mlab-modules/QFHMIX01/doc/src/img/QFHMIX01E_top.jpg

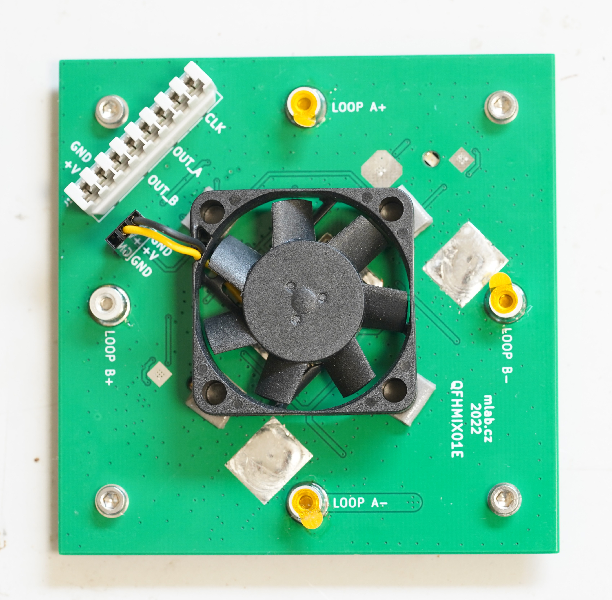
doc/src/img/QFHMIX01E_top.jpg
