mlab-modules/QFHMIX01/doc/gen/README.md

# PCB

Board size: 90.93x90.93 mm (3.58x3.58 inches)

- This is the size of the rectangle that contains the board
- Thickness: 1.6 mm (63 mils)
- Material: FR4
- Finish: None
- Layers: 2
- Copper thickness: 35 µm

Solder mask: TOP / BOTTOM

- Color: Green

Silk screen: TOP / BOTTOM

- Color: White

Stackup:

| Name | Type | Color | Thickness | Material | Epsilon_r | Loss tangent |
|---|---|---|---|---|---|---|
| F.SilkS | Top Silk Screen | | | | | |
| F.Paste | Top Solder Paste | | | | | |
| F.Mask | Top Solder Mask | Green | 10 | | | |
| F.Cu | copper | | 35 | | | |
| dielectric 1 | core | | 1510 | FR4 | 4.5 | 0.020 |
| B.Cu | copper | | 35 | | | |
| B.Mask | Bottom Solder Mask | Green | 10 | | | |
| B.Paste | Bottom Solder Paste  | | | | | |
| B.SilkS | Bottom Silk Screen | | | | | |

# Important sizes

Clearance: 0.15 mm (6 mils)

Track width: 0.2 mm (8 mils)

- By design rules: 0.2 mm (8 mils)

Drill: 0.4 mm (16 mils)

- Vias: 0.5 mm (20 mils) [Design: 0.4 mm (16 mils)]
- Pads: 0.4 mm (16 mils)
- The above values are real drill sizes, they add 0.1 mm (4 mils) to plated holes (PTH)

Via: 0.75/0.4 mm (30/16 mils)

- By design rules: 0.4/0.3 mm (16/12 mils)
- Micro via: no [0.2/0.1 mm (8/4 mils)]
- Burried/blind via: no

Outer Annular Ring: 0.1 mm (4 mils)

- By design rules: 0.1 mm (4 mils)

Eurocircuits class: 6C
- Using min drill 0.35 mm for an OAR of 0.13 mm

# General stats

Components count: (SMD/THT)

- Top: 0/2 (THT)
- Bottom: 218/15 (SMD + THT)

Defined tracks:

- 0.15 mm (6 mils)
- 0.2 mm (8 mils)
- 0.25 mm (10 mils)
- 0.3 mm (12 mils)
- 0.4 mm (16 mils)
- 0.5 mm (20 mils)
- 0.6 mm (24 mils)
- 0.8 mm (31 mils)

Used tracks:

- 0.2 mm (8 mils) (53) defined: yes
- 0.25 mm (10 mils) (71) defined: yes
- 0.3 mm (12 mils) (118) defined: yes
- 0.4 mm (16 mils) (157) defined: yes
- 0.5 mm (20 mils) (152) defined: yes
- 0.6 mm (24 mils) (42) defined: yes
- 0.8 mm (31 mils) (257) defined: yes
- 3.0 mm (118 mils) (22) defined: no

Defined vias:

Used vias:

- 0.75/0.4 mm (30/16 mils) (Count: 483, Aspect: 2.1 A) defined: no
- 1.0/0.5 mm (39/20 mils) (Count: 109, Aspect: 1.6 A) defined: no

Holes (excluding vias):

- 0.3 mm (12 mils) (27)
- 0.4 mm (16 mils) (48)
- 0.5 mm (20 mils) (60)
- 0.89 mm (35 mils) (6)
- 1.4 mm (55 mils) (8)
- 1.6 mm (63 mils) (6)
- 2.7 mm (106 mils) (2)
- 3.0 mm (118 mils) (4)
- 4.45 mm (175 mils) (4)

Oval holes:

Drill tools (including vias and computing adjusts and rounding):

- 0.4 mm (16 mils) (27)
- 0.5 mm (20 mils) (531)
- 0.6 mm (24 mils) (169)
- 1.0 mm (39 mils) (6)
- 1.5 mm (59 mils) (8)
- 1.6 mm (63 mils) (6)
- 2.7 mm (106 mils) (2)
- 3.1 mm (122 mils) (4)
- 4.45 mm (175 mils) (4)
