mlab-modules/QFHMIX01/doc/gen/img/QFHMIX01E-bottom.png

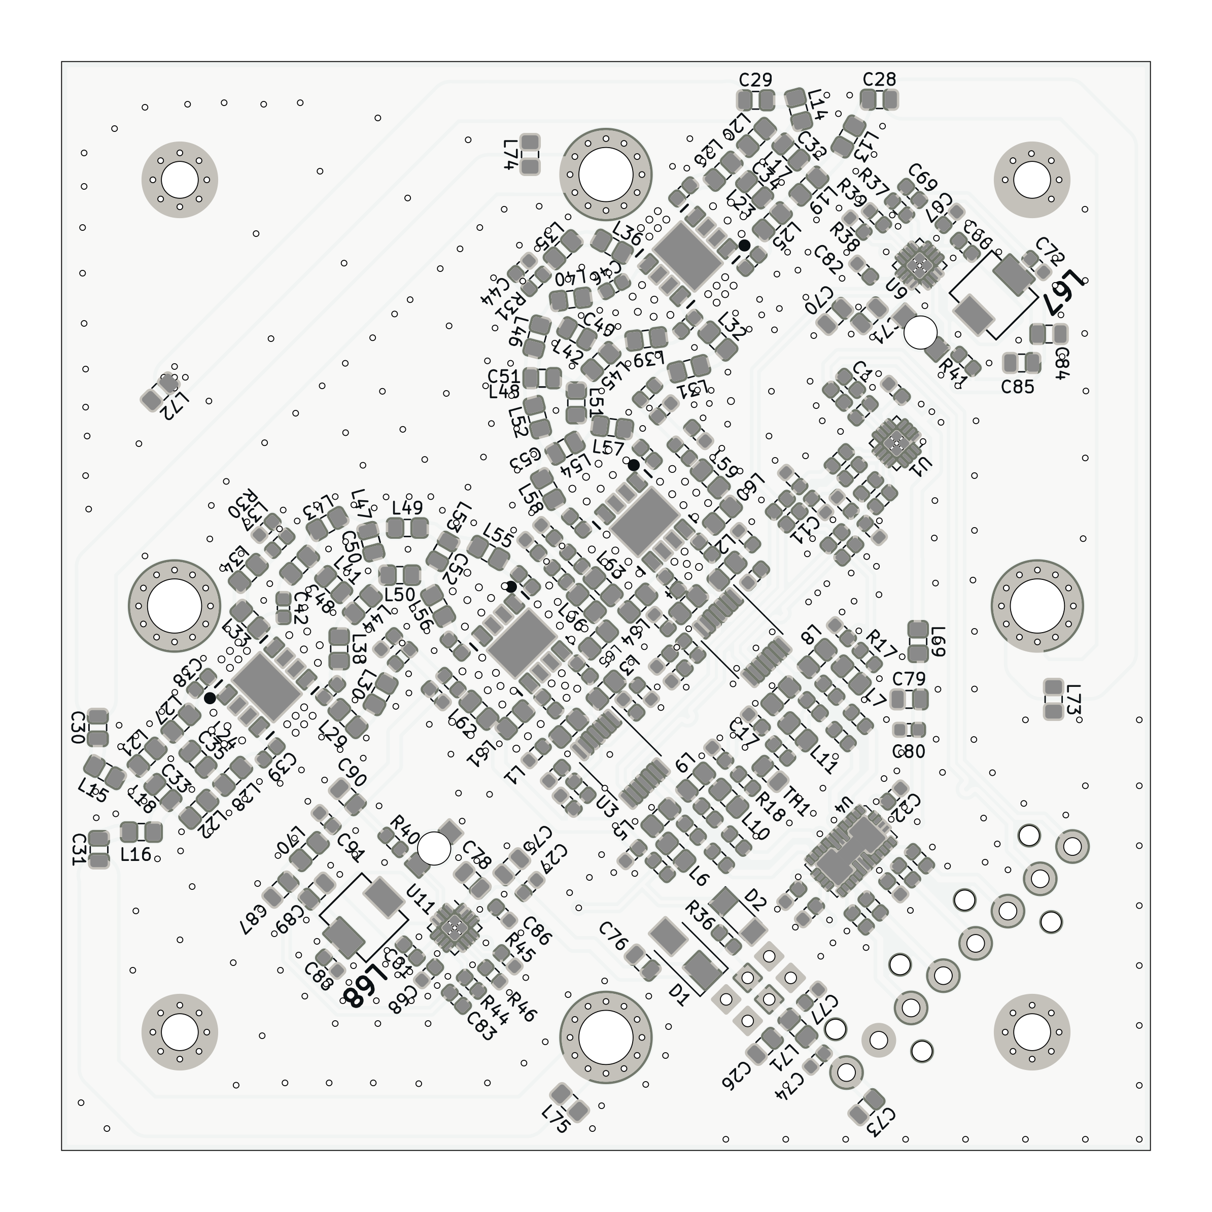
doc/gen/img/QFHMIX01E-bottom.png
