mlab-modules/QFHMIX01/doc/gen/img/QFHMIX01E-top.png

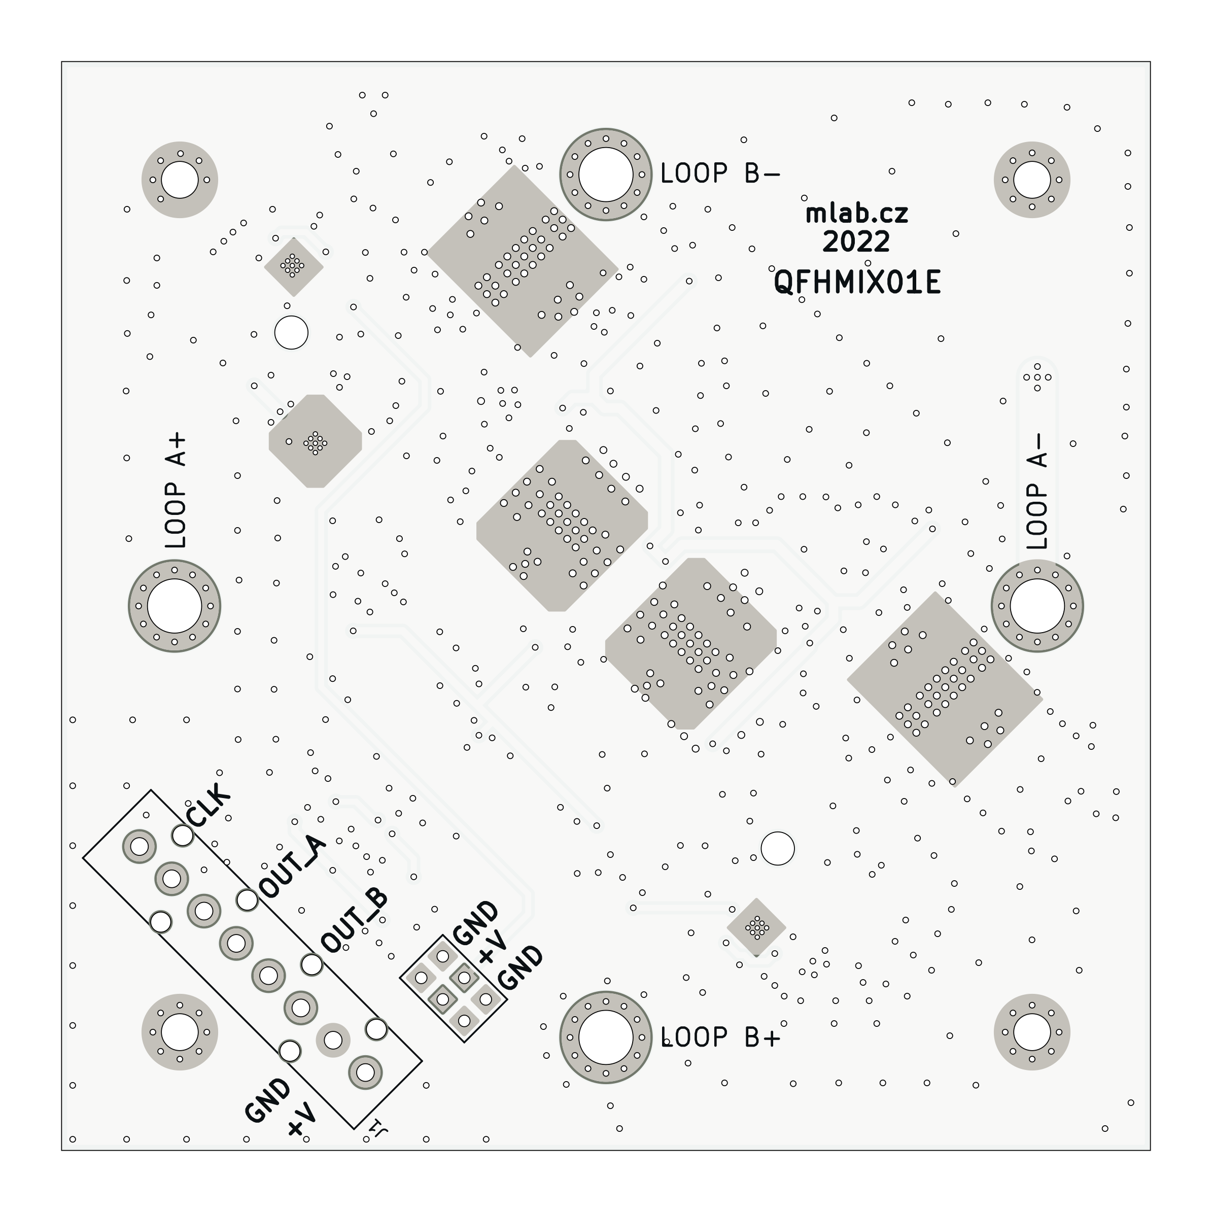
doc/gen/img/QFHMIX01E-top.png
