mlab-modules/QFHMIX01/doc/NoiceCalc.png

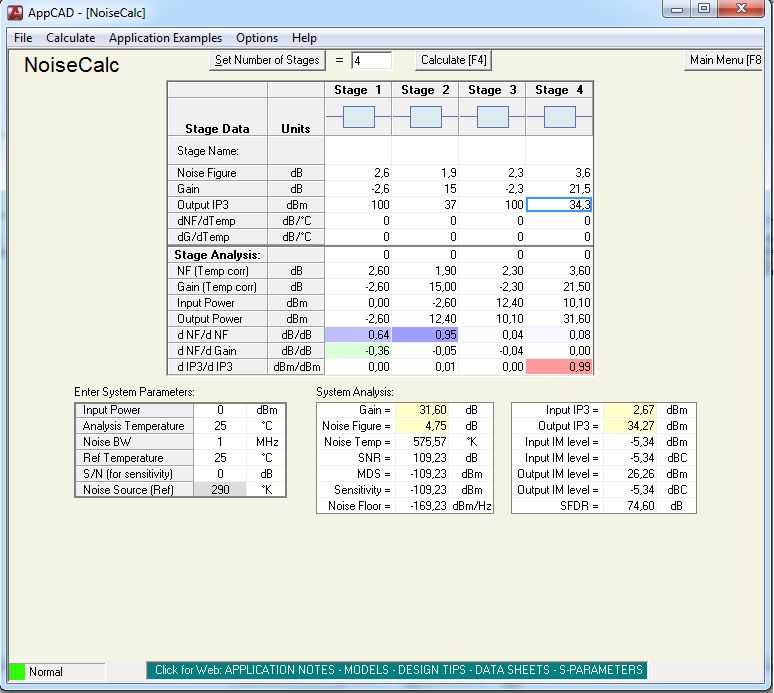
doc/NoiceCalc.png
