mlab-modules/QFHMIX01/doc/gen/dxf/QFHMIX01E-B_Fab.dxf

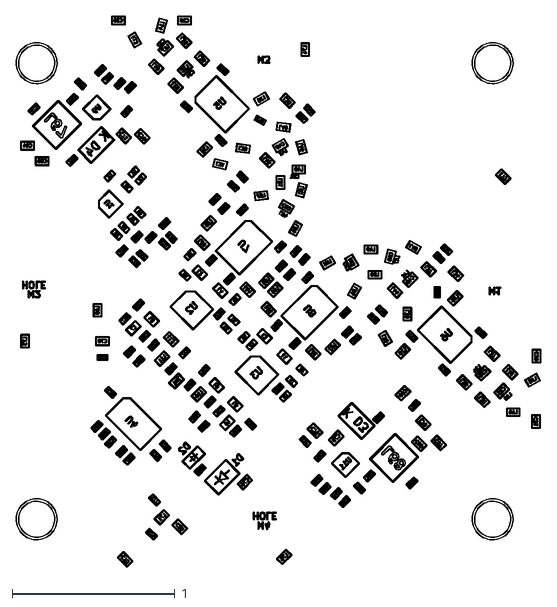
[picture p11: CAD file, 2022-08-20]
doc/gen/dxf/QFHMIX01E-B_Fab.dxf
3.22 x 3.38
