mlab-modules/QFHMIX01/doc/gen/QFHMIX01E.step

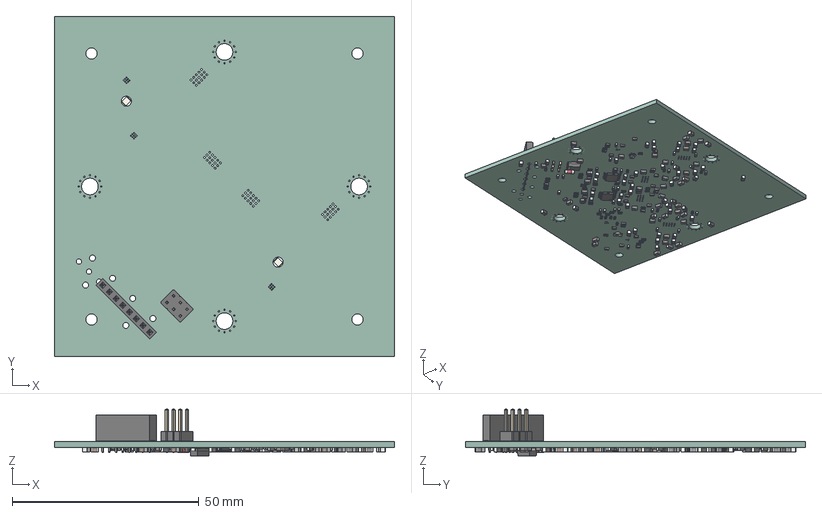
[picture p12: CAD file, 2023-02-14]
doc/gen/QFHMIX01E.step
90.9 x 90.9 x 12.5 mm
tmpxrz9fpc8 PCB
