mlab-modules/QFHMIX01/hw/cad/spacer.stl

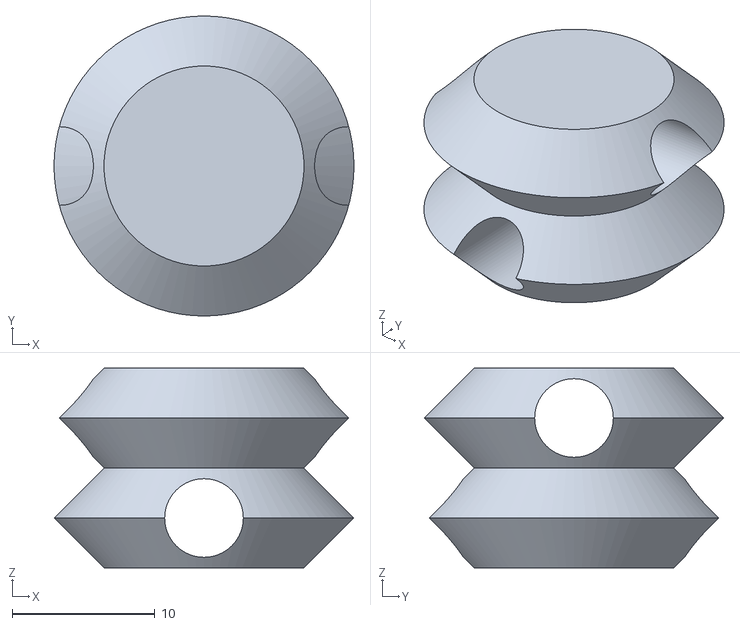
[picture p13: CAD file, 2022-09-10]
hw/cad/spacer.stl
21.0 x 21.0 x 14.0
