mlab-modules/QFHMIX01/doc/gen/dxf/QFHMIX01E-B_Cu.dxf

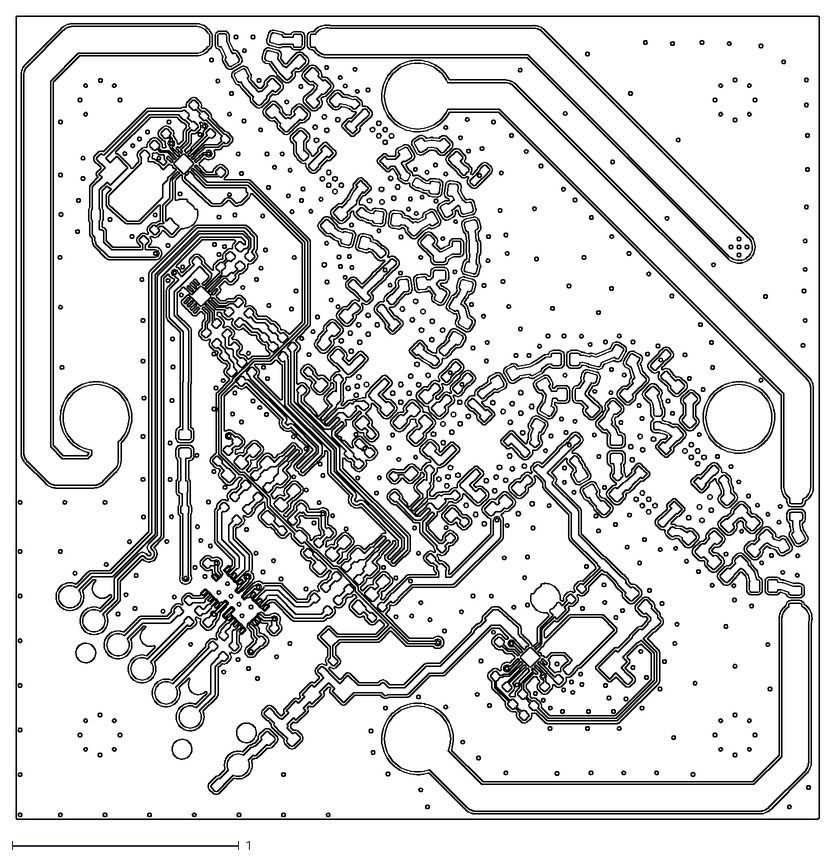
[picture p14: CAD file, 2022-08-10]
doc/gen/dxf/QFHMIX01E-B_Cu.dxf
3.54 x 3.54
