mlab-modules/QFHMIX01/hw/cad/ALBASE_MOLEX_93604.DXF

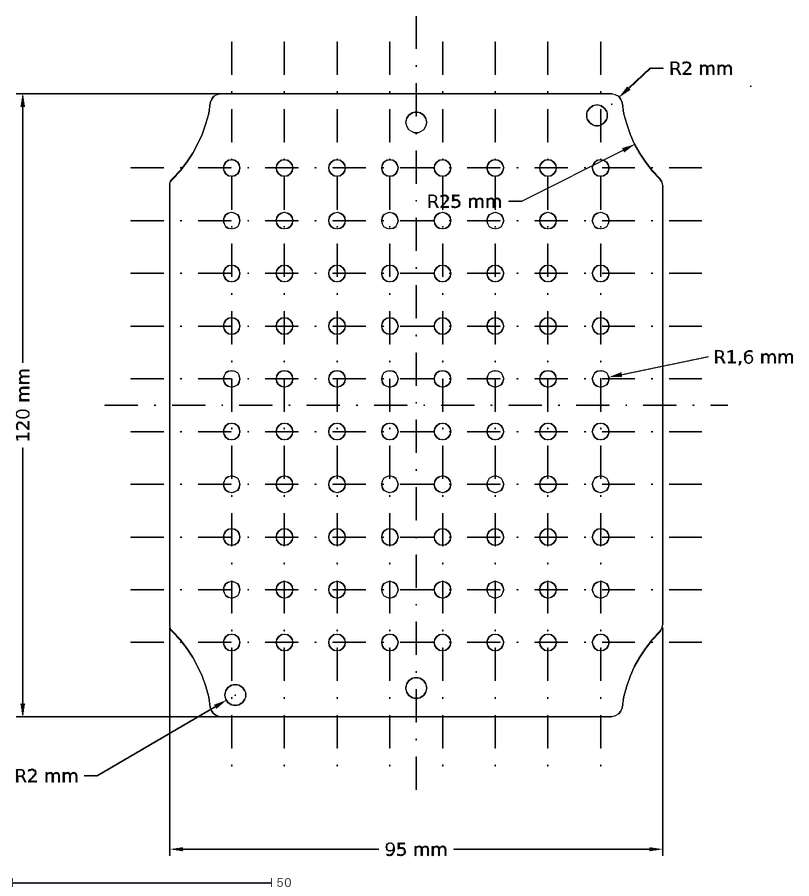
[picture p15: CAD file, 2020-06-15]
hw/cad/ALBASE_MOLEX_93604.DXF
120 mm
95 mm
R25 mm
R2 mm
R1,6 mm
