mlab-modules/QFHMIX01/doc/gen/dxf/QFHMIX01E-F_Fab.dxf

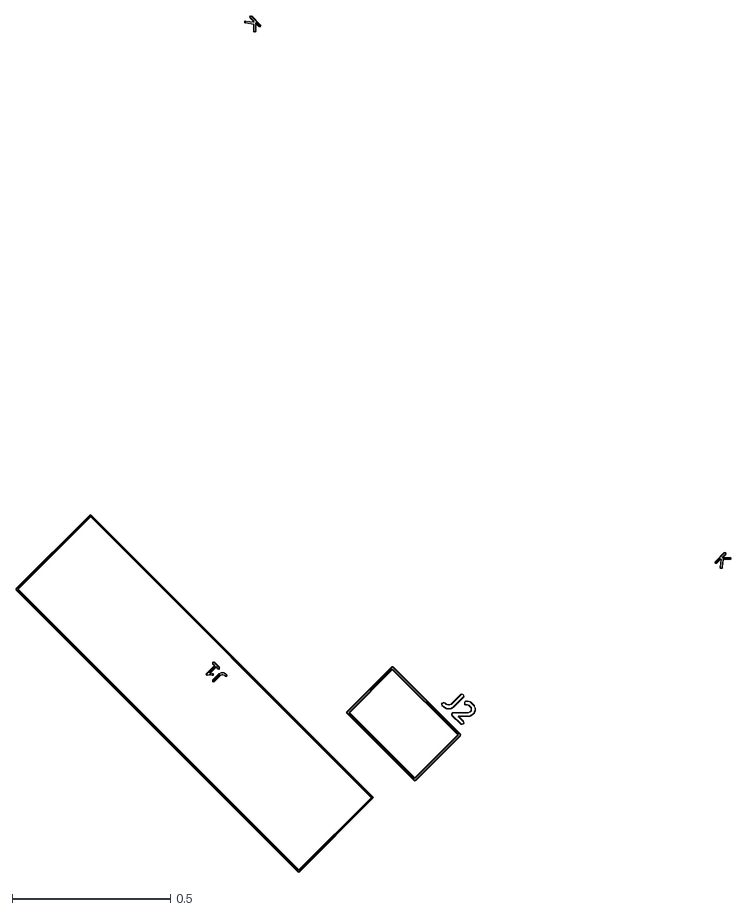
[picture p16: CAD file, 2022-08-10]
doc/gen/dxf/QFHMIX01E-F_Fab.dxf
2.26 x 2.70
