mlab-modules/QFHMIX01/hw/cad/ALBASE1209.dxf

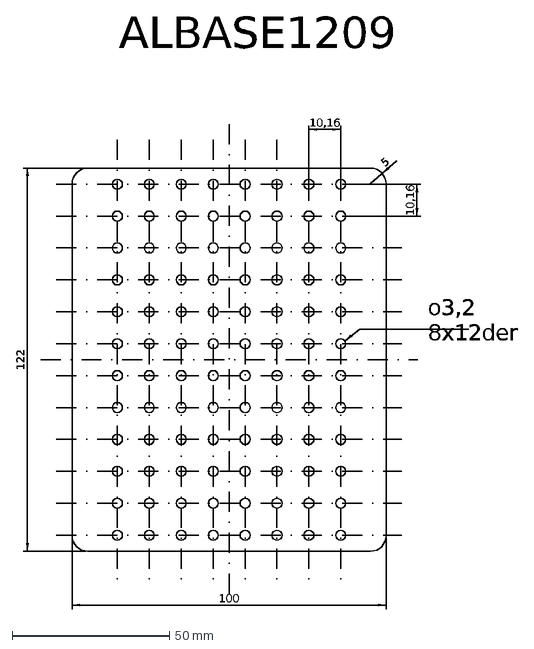
[picture p17: CAD file, 2020-06-15]
hw/cad/ALBASE1209.dxf
ALBASE1209
10,16
o3,2 8x12der
100
122
5
