mlab-modules/QFHMIX01/doc/gen/dxf/QFHMIX01E-F_Cu.dxf

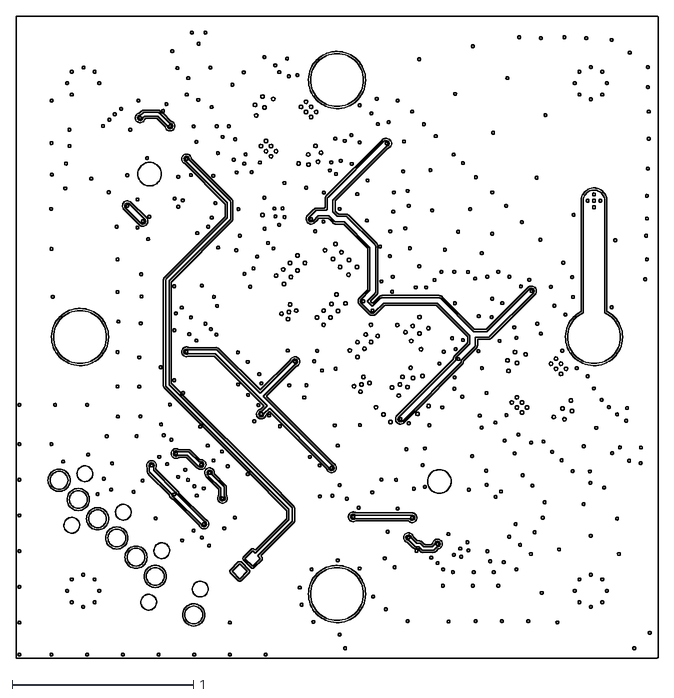
[picture p18: CAD file, 2022-08-10]
doc/gen/dxf/QFHMIX01E-F_Cu.dxf
3.54 x 3.54
