mlab-modules/QFHMIX01/doc/gen/dxf/QFHMIX01E-B_Courtyard.dxf

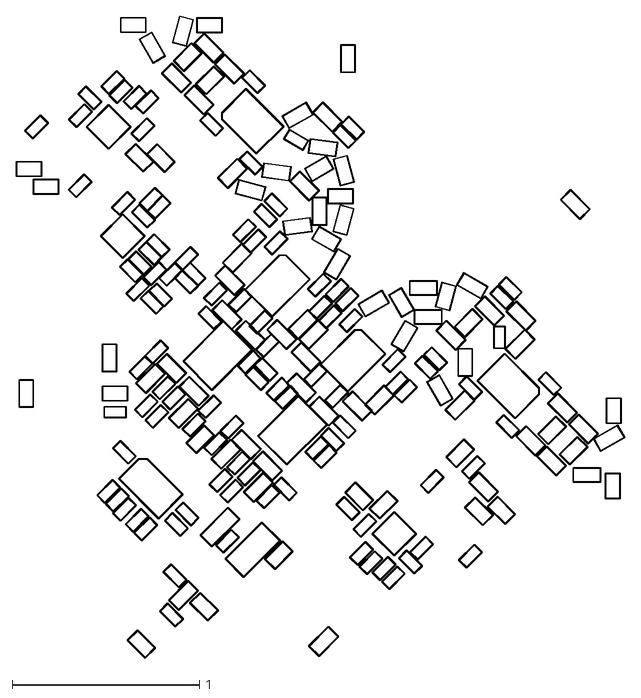
[picture p19: CAD file, 2022-08-10]
doc/gen/dxf/QFHMIX01E-B_Courtyard.dxf
3.25 x 3.43
