mlab-modules/QFHMIX01/doc/gen/dxf/QFHMIX01E-F_Adhesive.dxf

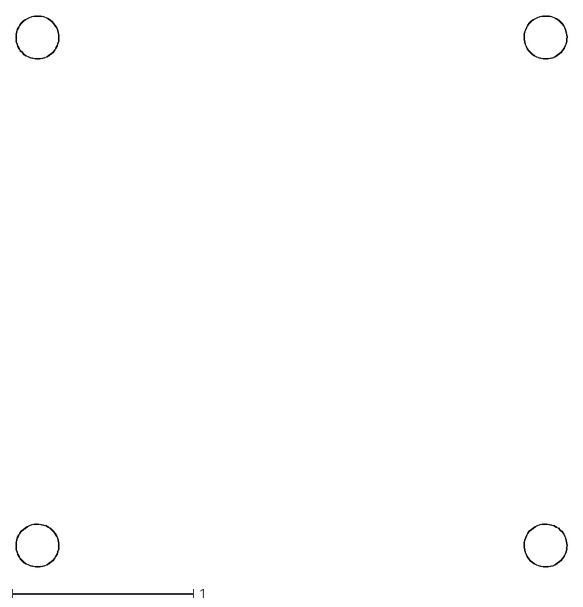
[picture p20: CAD file, 2022-06-22]
doc/gen/dxf/QFHMIX01E-F_Adhesive.dxf
3.04 x 3.04
