mlab-modules/QFHMIX01/doc/gen/dxf/QFHMIX01D-B_Fab.dxf

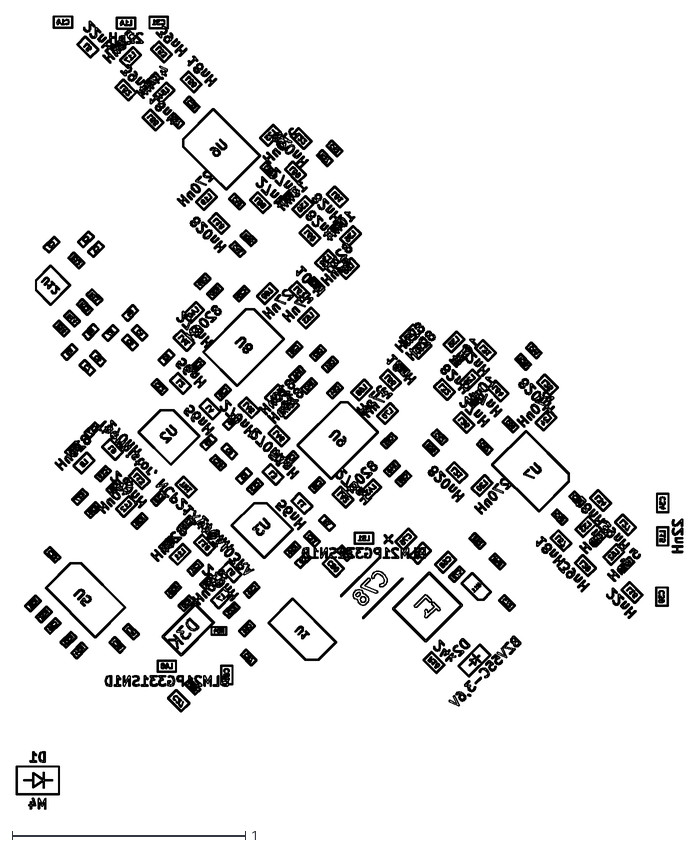
[picture p21: CAD file, 2022-06-01]
doc/gen/dxf/QFHMIX01D-B_Fab.dxf
2.86 x 3.40
