mlab-modules/QFHMIX01/doc/gen/dxf/QFHMIX01E-Edge_Cuts.dxf

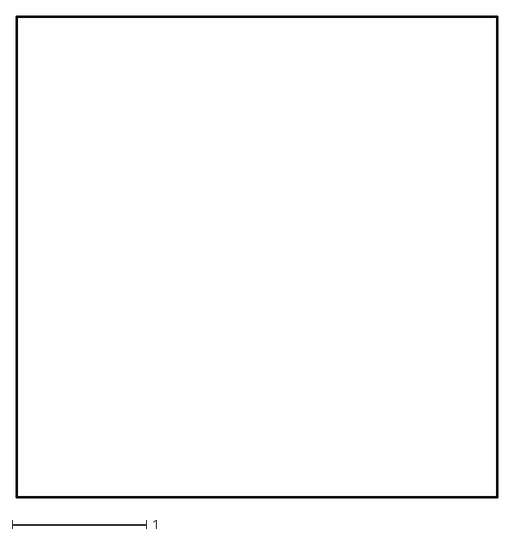
[picture p22: CAD file, 2022-04-04]
doc/gen/dxf/QFHMIX01E-Edge_Cuts.dxf
3.59 x 3.59
