mlab-modules/QFHMIX01/doc/gen/dxf/QFHMIX01E-F_Courtyard.dxf

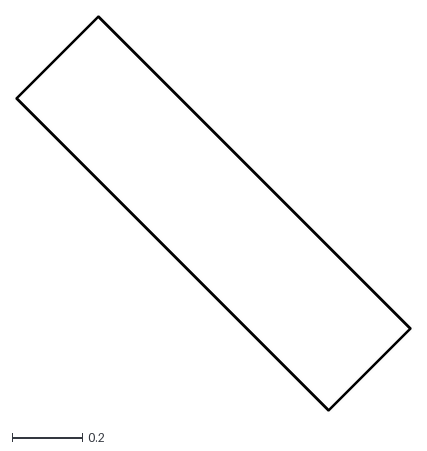
[picture p23: CAD file, 2022-04-04]
doc/gen/dxf/QFHMIX01E-F_Courtyard.dxf
1.13 x 1.13
