mlab-modules/QFHMIX01/(list of files, cad)

Other CAD files:
doc/gen/dxf/QFHMIX01E-User_Eco2.dxf
doc/gen/dxf/QFHMIX01E-User_Eco1.dxf
doc/gen/dxf/QFHMIX01E-User_Drawings.dxf
doc/gen/dxf/QFHMIX01E-User_Comments.dxf
doc/gen/dxf/QFHMIX01E-Margin.dxf
doc/gen/dxf/QFHMIX01E-B_Mask.dxf
doc/gen/dxf/QFHMIX01E-B_Paste.dxf
doc/gen/dxf/QFHMIX01E-B_Silkscreen.dxf
doc/gen/dxf/QFHMIX01E-F_Mask.dxf
doc/gen/dxf/QFHMIX01E-F_Paste.dxf
doc/gen/dxf/QFHMIX01E-F_Silkscreen.dxf
