mlab-modules/QFHMIX01/hw/cam_profi/docs/QFHMIX01E-B_Fab+Edge_Cuts.pdf

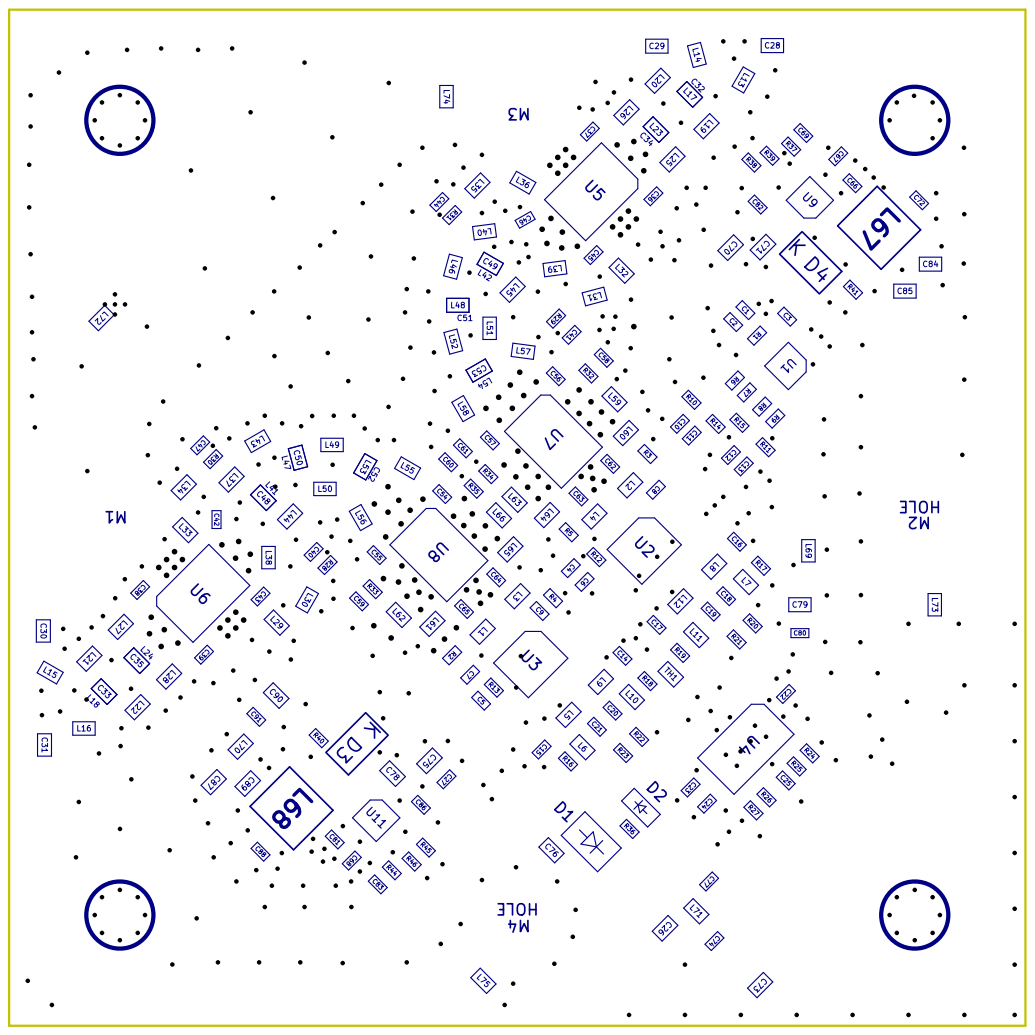
[picture p24: page 1]
