mlab-modules/QFHMIX01/hw/cam_profi/docs/QFHMIX01E-F_Fab+Edge_Cuts.pdf

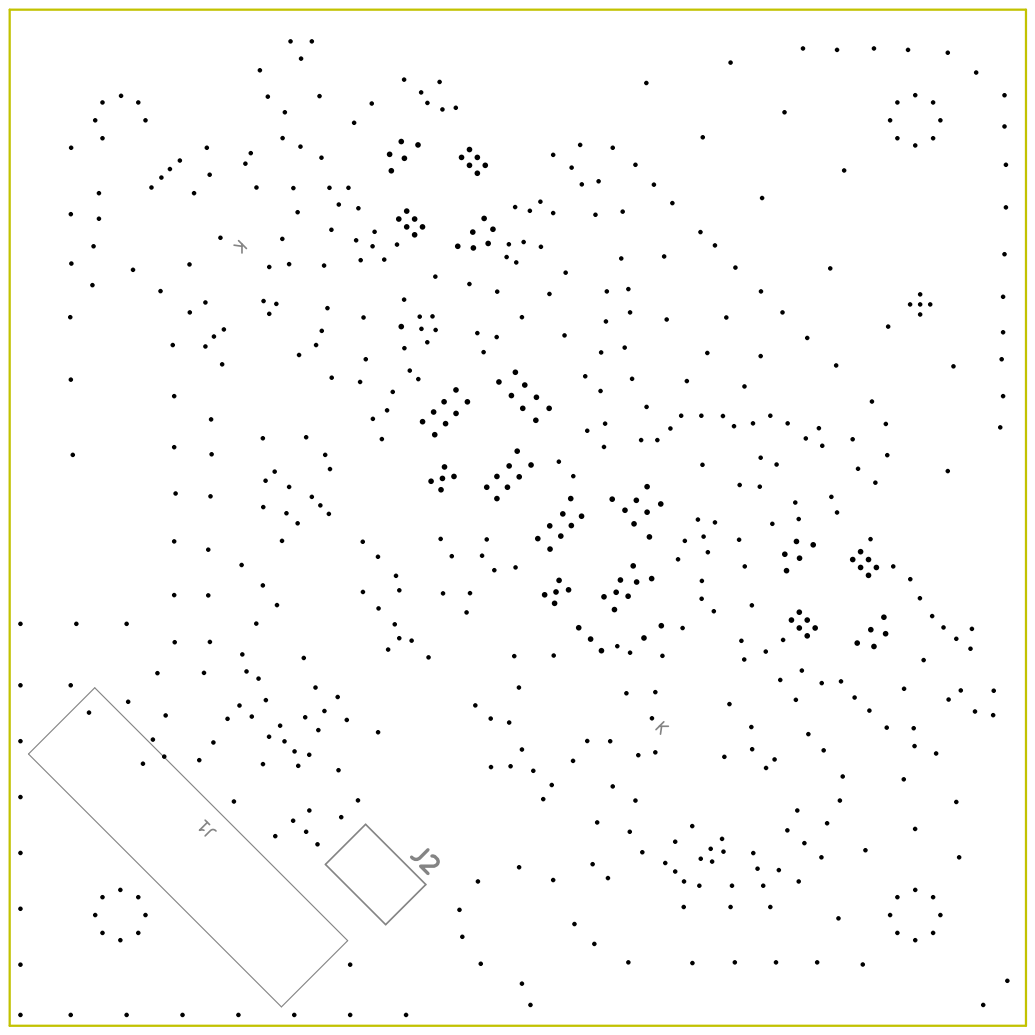
[picture p25: page 1]
