mlab-modules/QFHMIX01/(commit log)

2020-06-15 Initial commit of design.
    [ALBASE1209.dxf, ALBASE_MOLEX_93604.DXF, QFHMIX01A.kicad_pcb, QFHMIX01A.sch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]
2020-06-15 Initial design of modified version.
    [QFHMIX01A.kicad_pcb, QFHMIX01A.sch, QFHMIX01B.FCStd, QFHMIX01B.kicad_pcb, QFHMIX01B.sch]
2020-06-15 Initial commit of improved design.
    [LNA.sch, QFHMIX01B.FCStd, QFHMIX01B.kicad_pcb, QFHMIX01B.sch, QFHMIX01C.FCStd, QFHMIX01C.kicad_pcb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]
2020-06-20 Convesion to up to date kicad version.
    [LNA.kicad_sch, QFHMIX01C.FCStd, QFHMIX01C.kicad_sch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]
2020-06-20 Renaming the project to revision neutral name.
    [LNA.sch, QFHMIX01.kicad_pcb, QFHMIX01.kicad_sch, QFHMIX01C.sch, _saved_DEM_BUFF.sch]
2020-06-20 Fix #3
    [LNA.kicad_sch, QFHMIX01.kicad_sch]
2020-06-20 Fix #8
    [LNA.kicad_sch, QFHMIX01.kicad_sch]
2020-06-20 Fix #9
    [LNA.kicad_sch, QFHMIX01.kicad_sch]
2020-07-09 Edit schema
    [LNA.kicad_sch, QFHMIX01.kicad_sch]
2020-07-09 New kicad project file.
2020-07-30 Pridani odporu.
    [LNA.kicad_sch, QFHMIX01.kicad_sch]
2020-11-12 KiCAD project cleanup.
2020-11-18 Update resistors value to increase DC gain.
    [LNA.kicad_sch, Power.kicad_sch, QFHMIX01.kicad_sch]
2021-04-21 Begin of RF filter improvement.
    [LNA.kicad_sch, Power.kicad_sch, QFHMIX01.kicad_sch]
2021-04-22 Redesign RF filter schematics #13
    [LNA.kicad_sch, QFHMIX01.kicad_sch]
2021-04-28 Fix duplicated annotations.
    [LNA.kicad_sch, QFHMIX01.kicad_sch]
2021-05-05 Update older version of the PCB (e970d728ea8afdcb96f268d7512686923dc0fbc7) from up to date schematics.
    [LNA.kicad_sch, Power.kicad_sch, QFHMIX01.kicad_pcb, QFHMIX01.kicad_sch]
2021-05-05 Convert commit e970d728ea8afdcb96f268d7512686923dc0fbc7 of PCB to kicad new format. (Without any changes)
    [QFHMIX01.kicad_pcb]
2021-05-06 Edit pouzdra
    [LNA.kicad_sch, Power.kicad_sch, QFHMIX01.kicad_sch]
2021-05-06 Oprava PCB.
    [LNA.kicad_sch, Power.kicad_sch, QFHMIX01.kicad_pcb, QFHMIX01.kicad_sch]
2021-05-06 Edit PCB
    [Power.kicad_sch, QFHMIX01.kicad_pcb, QFHMIX01.kicad_sch]
2021-06-21 Edit UST_ID
    [LNA.kicad_sch, Power.kicad_sch, QFHMIX01.kicad_sch]
2021-06-23 Edit UST ID
    [LNA.kicad_sch, Power.kicad_sch, QFHMIX01.csv, QFHMIX01.kicad_sch]
2021-06-24 Rotate connection block.
    [LNA.kicad_sch, Power.kicad_sch, QFHMIX01.kicad_pcb, QFHMIX01.kicad_sch]
2021-06-25 Improve components placement.
    [QFHMIX01.kicad_pcb]
2021-06-27 Layout improvement.
    [LNA.kicad_sch, Power.kicad_sch, QFHMIX01.kicad_pcb, QFHMIX01.kicad_sch]
2021-06-28 RF filter layout improvement.
    [QFHMIX01.kicad_pcb]
2021-06-28 RF layout.
    [QFHMIX01.kicad_pcb]
2021-06-28 Switching regulator layout improvement.
    [LNA.kicad_sch, Power.kicad_sch, QFHMIX01.kicad_pcb, QFHMIX01.kicad_sch]
2021-06-28 Eliminate vias on RF LO tracks.
    [QFHMIX01.kicad_pcb]
2021-06-28 Layout improvements.
    [Power.kicad_sch, QFHMIX01.kicad_pcb, QFHMIX01.kicad_sch]
2021-06-29 Resolve device package conflicts.
    [LNA.kicad_sch, Power.kicad_sch, QFHMIX01.kicad_pcb, QFHMIX01.kicad_sch]
2021-06-29 RF layout improvement.
    [QFHMIX01.kicad_pcb]
2021-06-29 Tune skew lenght.
    [QFHMIX01.kicad_pcb]
2021-06-30 Edit B.FAB
    [QFHMIX01D.kicad_pcb]
2021-07-04 Add notes to measured values.
    [LNA.kicad_sch, QFHMIX01D.kicad_pcb, QFHMIX01D.kicad_sch]
2021-08-05 Udate schematics with comments.
2022-04-04 Update actions products
    [QFHMIX01D-B_Cu.gbr, QFHMIX01D-B_Mask.gbr, QFHMIX01D-Edge_Cuts.gbr, QFHMIX01D-F_Cu.gbr, QFHMIX01D-F_Mask.gbr, QFHMIX01D-F_Silkscreen.gbr, QFHMIX01D-NPTH.drl, QFHMIX01D-PTH.drl]
2022-04-04 aktualizace verze kicadu
    [LNA.kicad_sch, Power.kicad_sch, QFHMIX01D.kicad_pcb, QFHMIX01D.kicad_sch]
2022-05-26 Zmena pouzder L 0805.
    [LNA.kicad_sch, Power.kicad_sch, QFHMIX01D.kicad_sch]
2022-05-26 Zmena pouzdra L 0805
    [QFHMIX01D.kicad_pcb]
2022-05-26 Add a link to clock buffer datasheet.
    [LNA.kicad_sch, Power.kicad_sch, QFHMIX01D.kicad_sch]
2022-06-01 Add thermistor #22, align text labels
    [Power.kicad_sch, QFHMIX01D.kicad_pcb, QFHMIX01D.kicad_sch]
2022-06-01 reseni nekterych DRC prolemu
    [QFHMIX01D.kicad_pcb]
2022-06-01 rozpracovani #11 (menic na 5 a 3v3)
    [LNA.kicad_sch, Power.kicad_sch, QFHMIX01D.kicad_pcb, QFHMIX01D.kicad_sch]
2022-06-02 uprava ledek napajeni #11
    [Power.kicad_sch, QFHMIX01D.kicad_sch]
2022-06-05 navrzeni soucastek regulatoru pro 5v #11
    [Power.kicad_sch, QFHMIX01D.kicad_sch]
2022-06-22 Pridani novych otvoru pro sloupky pro montaz anteny #20, WIP
    [Power.kicad_sch, QFHMIX01D.kicad_pcb, QFHMIX01D.kicad_sch]
2022-07-18 Uprava otvoru pro M3 sloupky na montaz anteny - pridani prokovu pro spojeni horni a spodni strany, vytvoreni NPTH
    [QFHMIX01D.kicad_pcb]
2022-07-31 Cleanup title block update assets submodule.
    [LNA.kicad_sch, Power.kicad_sch, QFHMIX01D.kicad_sch]
2022-07-31 Renaming project to match name of new revision.
    [LNA.kicad_sch, Power.kicad_sch, QFHMIX01E.csv, QFHMIX01E.kicad_pcb, QFHMIX01E.kicad_sch]
2022-07-31 Add filter capacitors at swithinch power supply inputs.
    [Power.kicad_sch, QFHMIX01E.kicad_sch]
2022-08-01 Change decrease impedance of feedback divider network.
    [Power.kicad_sch, QFHMIX01E.kicad_sch]
2022-08-02 cleanup schematics.
    [QFHMIX01E.kicad_sch]
2022-08-04 Define footprints of new components and update PCB.
    [Power.kicad_sch, QFHMIX01E.kicad_pcb, QFHMIX01E.kicad_sch]
2022-08-04 Grouping components according to function.
    [Power.kicad_sch, QFHMIX01E.kicad_pcb, QFHMIX01E.kicad_sch]
2022-08-05 First attempt of 3.3V switching power supply layout.
    [QFHMIX01E.kicad_pcb]
2022-08-06 All components placed in PCB layout.
    [Power.kicad_sch, QFHMIX01E.kicad_pcb, QFHMIX01E.kicad_sch]
2022-08-07 Removed duplicite copper pour.
    [Power.kicad_sch, QFHMIX01E.kicad_pcb, QFHMIX01E.kicad_sch]
2022-08-07 The firts dirty layout of new switched power supplies.
    [Power.kicad_sch, QFHMIX01E.kicad_pcb, QFHMIX01E.kicad_sch]
2022-08-07 cleaner connections
    [QFHMIX01E.kicad_pcb]
2022-08-08 Improve layout of 3v3 power supply.
    [QFHMIX01E.kicad_pcb]
2022-08-09 RF filters layout changed. Inductors are now over capacitors.
    [LNA.kicad_sch, QFHMIX01E.kicad_pcb, QFHMIX01E.kicad_sch]
2022-08-09 Improve layout resolve some DRC erorrs.
    [QFHMIX01E.kicad_pcb]
2022-08-09 Improve silkscreen.
    [QFHMIX01E.kicad_pcb]
2022-08-09 cleanup ground layout.
    [QFHMIX01E.kicad_pcb]
2022-08-09 Add solder mask keepout to increase cooling capacity. #18.
    [QFHMIX01E.kicad_pcb]
2022-08-10 Aktualizace mlab pouzder.
    [LNA.kicad_sch, Power.kicad_sch, QFHMIX01E.kicad_pcb, QFHMIX01E.kicad_sch]
2022-08-10 cleanup bottom silkscreen.
    [QFHMIX01E.kicad_pcb]
2022-08-10 Resolve unconnected tracks.
    [QFHMIX01E.kicad_pcb]
2022-08-10 fix rules check errors.
    [LNA.kicad_sch, Power.kicad_sch, QFHMIX01E.kicad_pcb, QFHMIX01E.kicad_sch]
2022-08-10 Update UST_IDs to match new 805 footprint of resonators.
    [LNA.kicad_sch, Power.kicad_sch, QFHMIX01E.kicad_sch]
2022-08-10 Cleanup B.Fab layer to allow manual manufacturing.
    [QFHMIX01E.kicad_pcb]
2022-08-11 Update LT6604 to 5MHz bandwidth variant.
    [QFHMIX01E.kicad_sch]
2022-08-16 Tune value of PG pin LED resistors.
    [LNA.kicad_sch, Power.kicad_sch, QFHMIX01E.kicad_sch]
2022-08-20 Fix issue in Inductors marking. Swap C27 and C75 in silkscreen.
    [QFHMIX01E.kicad_pcb]
2022-08-22 Add notes to schematics.
    [QFHMIX01E.kicad_sch]
2022-08-24 Add note about gain settings to schematics.
    [QFHMIX01E.kicad_sch]
2022-08-25 Update photos to current version.
2022-09-05 Adding loop spacer.
    [spacer.scad]
2022-09-10 finished version of loop spacer.
    [spacer.scad, spacer.stl]
2023-02-06 Move IC to schematics grid.
    [LNA.kicad_sch, Power.kicad_sch, QFHMIX01E.kicad_sch]
2023-02-14 update kicad version
    [LNA.kicad_sch, Power.kicad_sch, QFHMIX01E.kicad_pcb, QFHMIX01E.kicad_sch]
2023-07-05 automated commit; rename source files to new naming convence
    [LN.kicad_sch]
2024-05-10 Fix wrong rename. Update to KiCAD 7. Update readme.
    [LNA.kicad_sch, Power.kicad_sch, QFHMIX01E.kicad_pcb, QFHMIX01E.kicad_sch]
